hslu-ares/ares-parachute-pcb/ares-parachute-board.kicad_sch

## KiCad design ares-parachute-board.kicad_sch (2025-02-18)

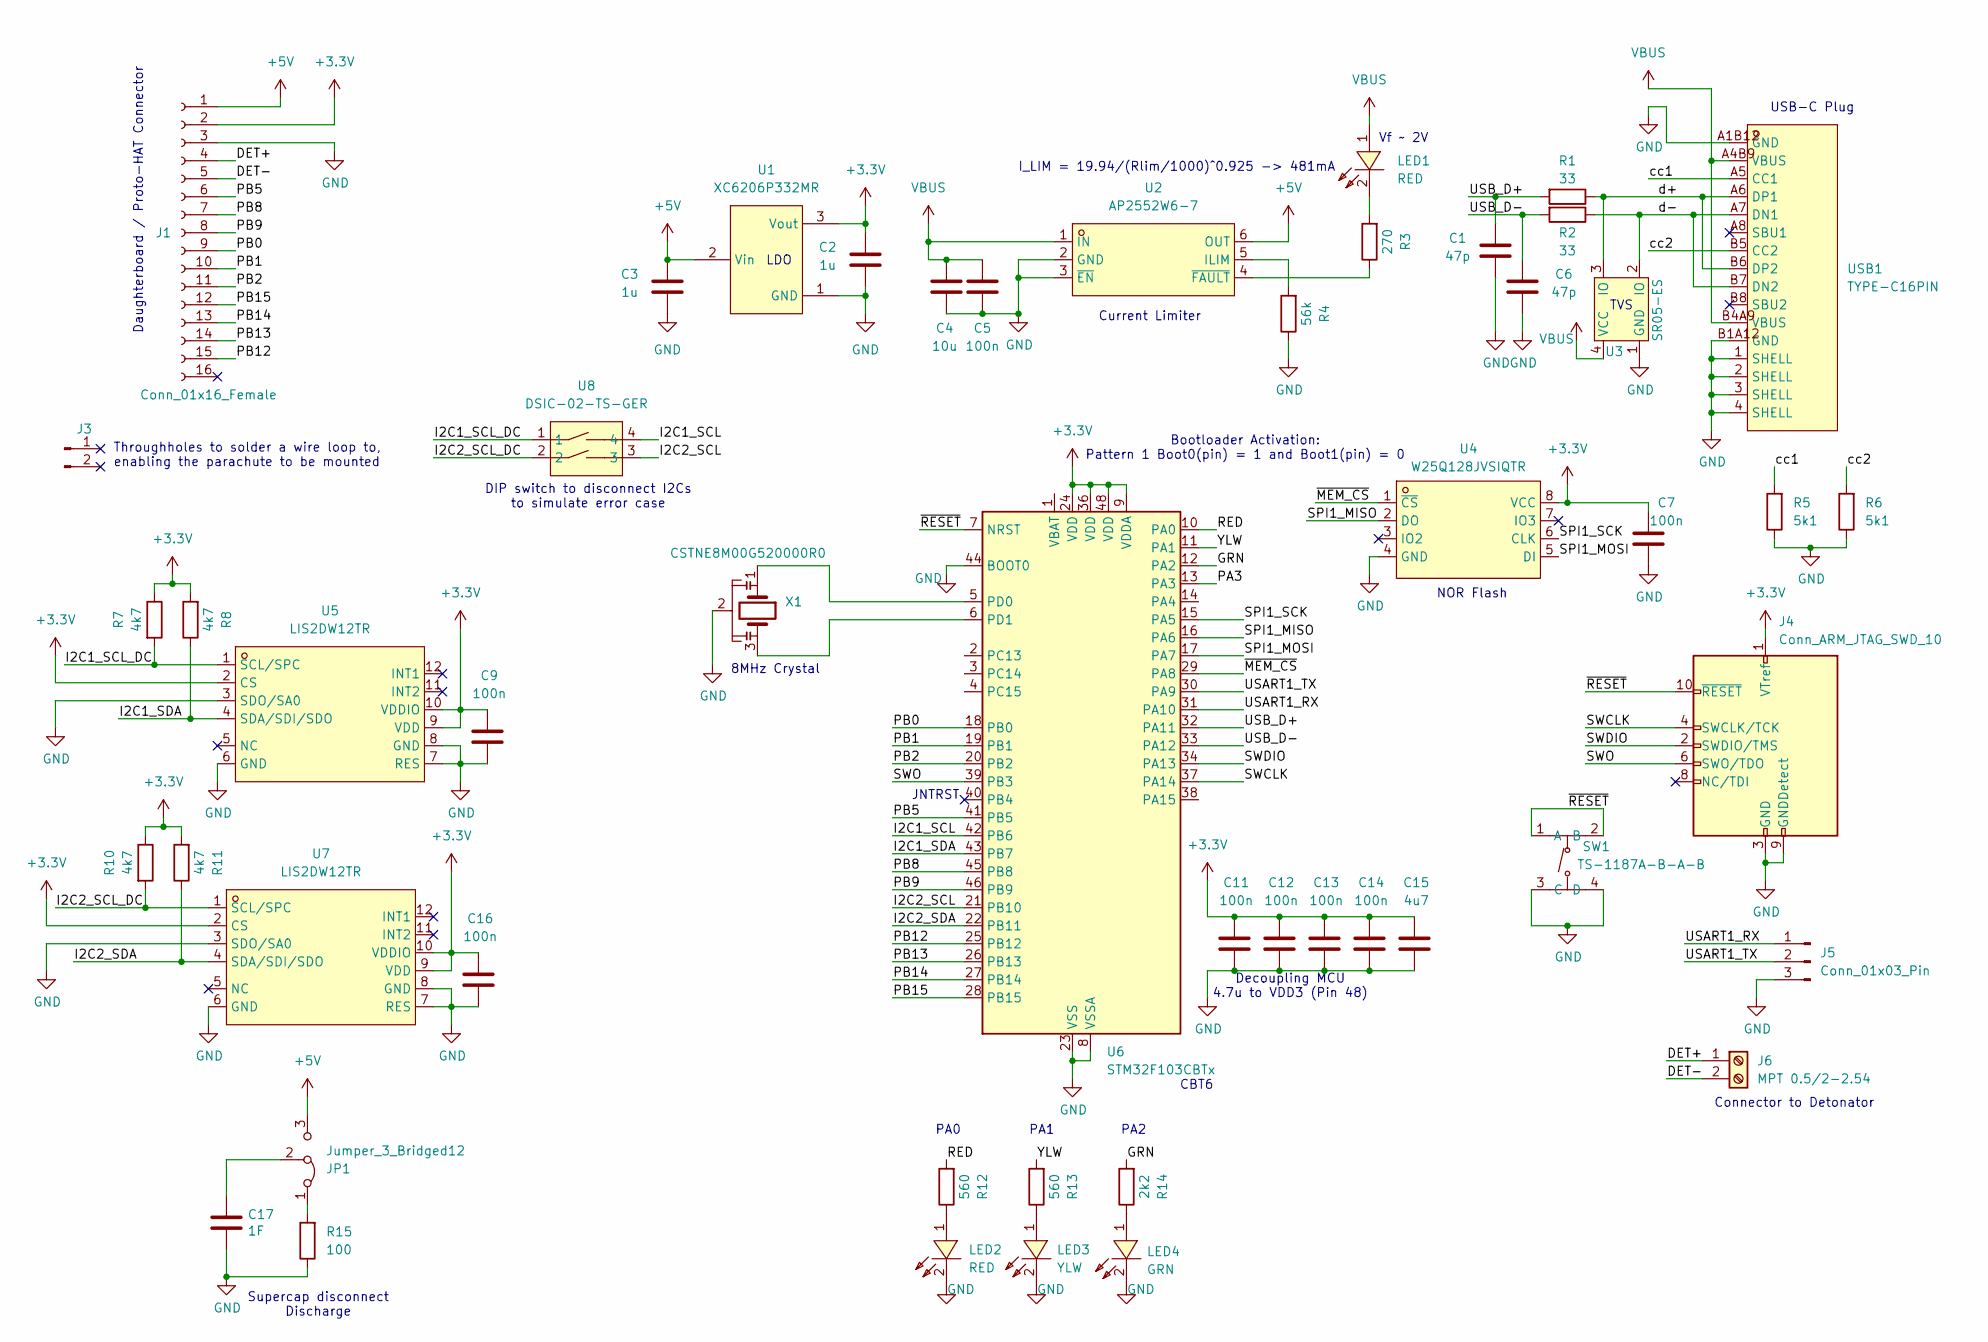
[picture p1: schematic ares-parachute-board.kicad_sch]

Parts:
C1, C6: 47p; C_0603_1608Metric; LCSC Part C1648
C2, C3: 1u; C_0603_1608Metric; LCSC Part C1648
C4: 10u; C_0603_1608Metric; LCSC Part C1648
C5, C7, C9, C11, C12, C13, C14, C16: 100n; C_0603_1608Metric; LCSC Part C1648
C15: 4u7; C_0603_1608Metric; LCSC Part C1648
C17: 1F; SCMR18C105MRBA0; Mouser 581-SCMR18C105MRBA0
J1: Conn_01x16_Female; PinHeader_1x16_P2.54mm_Vertical
J3: Conn_01x02_Male; PinHeader_1x02_P2.54mm_Vertical
J4: Conn_ARM_JTAG_SWD_10; PinHeader_2x05_P1.27mm_Vertical; LCSC Part C7501289
J5: Conn_01x03_Pin; PinHeader_1x03_P2.54mm_Horizontal
J6: MPT 0.5/2-2.54; TerminalBlock_Phoenix_MPT-0,5-2-2.54_1x02_P2.54mm_Horizontal
JP1: Jumper_3_Bridged12; PinHeader_1x03_P2.54mm_Horizontal
LED1, LED2: RED; LED0805-R-RD; LCSC Part C84256
LED3: YLW; LED0805-R-RD; LCSC Part C2296
LED4: GRN; LED0805-R-RD; LCSC Part C2297
R1, R2: 33; R_0603_1608Metric; LCSC C23140
R3: 270; R_0603_1608Metric; LCSC C22966
R4: 56k; R_0603_1608Metric; LCSC C23206
R5, R6: 5k1; R_0603_1608Metric; LCSC C23186
R7, R8, R10, R11: 4k7; R_0603_1608Metric; LCSC C23162
R12, R13: 560; R_0603_1608Metric; LCSC C23204
R14: 2k2; R_0603_1608Metric; LCSC C4190
R15: 100; R_0603_1608Metric; LCSC C22775
SW1: TS-1187A-B-A-B; SW-SMD_4P-L5.1-W5.1-P3.70-LS6.5-TL_H1.5; LCSC Part C318884
U1: XC6206P332MR; SOT-23-3_L2.9-W1.6-P1.90-LS2.8-BR; LCSC Part C5446
U2: AP2552W6-7; SOT-26_L3.0-W1.6-P0.95-LS2.8-BL; LCSC Part C441824
U3: SR05-ES; SOT-143; LCSC Part C5180250
U4: W25Q128JVSIQTR; SOIC-8_L5.3-W5.3-P1.27-LS8.0-BL; LCSC Part C97521
U5, U7: LIS2DW12TR; LGA-12_L2.0-W2.0-P0.50-BL; LCSC Part C189624
U6: STM32F103CBTx; LQFP-48_7x7mm_P0.5mm; LCSC C8304
U8: DSIC-02-TS-GER; SW-SMD_DSIC-02-TS-GER; LCSC Part C7471373
USB1: TYPE-C16PIN; USB-C-SMD_TYPE-C16PIN; LCSC Part C393939
X1: CSTNE8M00G520000R0; OSC-SMD_3P-L3.2-W1.3-P1.20; LCSC Part C907975

Connections:
+3.3V: C2.1, C7.1, C9.1, C11.1, C12.1, C13.1, C14.1, C15.1, C16.1, J1.2, J4.1 (VTref), R7.1, R8.2, R10.1, R11.2, U1.3 (Vout), U4.8 (VCC), U5.2 (CS), U5.9 (VDD), U5.10 (VDDIO), U6.9 (VDDA), U6.24 (VDD), U6.36 (VDD), U6.48 (VDD), U7.2 (CS), U7.9 (VDD), U7.10 (VDDIO)
+5V: C3.1, J1.1, JP1.3 (B), U1.2 (Vin), U2.6 (OUT)
DET+: J1.4, J6.1
DET-: J1.5, J6.2
GND: C1.2, C2.2, C3.2, C4.2, C5.2, C6.2, C7.2, C9.2, C11.2, C12.2, C13.2, C14.2, C15.2, C16.2, C17.2, J1.3, J4.3 (GND), J4.5 (GND), J4.9 (GNDDetect), J5.3, LED2.2, LED3.2, LED4.2, R4.1, R5.1, R6.1, R15.1, SW1.3 (C), SW1.4 (D), U1.1 (GND), U2.2 (GND), U2.3 (~EN), U3.1 (GND), U4.4 (GND), U5.3 (SDO/SA0), U5.6 (GND), U5.7 (RES), U5.8 (GND), U6.8 (VSSA), U6.23 (VSS), U6.35 (VSS), U6.44 (BOOT0), U6.47 (VSS), U7.3 (SDO/SA0), U7.6 (GND), U7.7 (RES), U7.8 (GND), USB1.1 (SHELL), USB1.2 (SHELL), USB1.3 (SHELL), USB1.4 (SHELL), USB1.A1B12 (GND), USB1.B1A12 (GND), X1.2
GRN: R14.2, U6.12 (PA2)
I2C1_SCL: U6.42 (PB6), U8.4
I2C1_SCL_DC: R7.2, U5.1 (SCL/SPC), U8.1
I2C1_SDA: R8.1, U5.4 (SDA/SDI/SDO), U6.43 (PB7)
I2C2_SCL: U6.21 (PB10), U8.3
I2C2_SCL_DC: R10.2, U7.1 (SCL/SPC), U8.2
I2C2_SDA: R11.1, U6.22 (PB11), U7.4 (SDA/SDI/SDO)
unnamed: C17.1, JP1.2 (C)
unnamed: JP1.1 (A), R15.2
unnamed: LED1.2, R3.2
unnamed: LED2.1, R12.1
unnamed: LED3.1, R13.1
unnamed: LED4.1, R14.1
unnamed: R3.1, U2.4 (~FAULT)
unnamed: R4.2, U2.5 (ILIM)
unnamed: U6.5 (PD0), X1.1
unnamed: U6.6 (PD1), X1.3
PA3: U6.13 (PA3)
PB0: J1.9, U6.18 (PB0)
PB1: J1.10, U6.19 (PB1)
PB2: J1.11, U6.20 (PB2)
PB5: J1.6, U6.41 (PB5)
PB8: J1.7, U6.45 (PB8)
PB9: J1.8, U6.46 (PB9)
PB12: J1.15, U6.25 (PB12)
PB13: J1.14, U6.26 (PB13)
PB14: J1.13, U6.27 (PB14)
PB15: J1.12, U6.28 (PB15)
RED: R12.2, U6.10 (PA0)
SPI1_MISO: U4.2 (DO), U6.16 (PA6)
SPI1_MOSI: U4.5 (DI), U6.17 (PA7)
SPI1_SCK: U4.6 (CLK), U6.15 (PA5)
SWCLK: J4.4 (SWCLK/TCK), U6.37 (PA14)
SWDIO: J4.2 (SWDIO/TMS), U6.34 (PA13)
SWO: J4.6 (SWO/TDO), U6.39 (PB3)
USART1_RX: J5.1, U6.31 (PA10)
USART1_TX: J5.2, U6.30 (PA9)
USB_D+: C1.1, R1.2, U6.32 (PA11)
USB_D-: C6.1, R2.2, U6.33 (PA12)
VBUS: C4.1, C5.1, LED1.1, U2.1 (IN), U3.4 (VCC), USB1.A4B9 (VBUS), USB1.B4A9 (VBUS)
YLW: R13.2, U6.11 (PA1)
cc1: R5.2, USB1.A5 (CC1)
cc2: R6.2, USB1.B5 (CC2)
d+: R1.1, U3.3 (IO), USB1.A6 (DP1), USB1.B6 (DP2)
d-: R2.1, U3.2 (IO), USB1.A7 (DN1), USB1.B7 (DN2)
~MEM_CS: U4.1 (~CS), U6.29 (PA8)
~RESET: J4.10 (~RESET), SW1.1 (A), SW1.2 (B), U6.7 (NRST)

Notes on the sheet:
TVS
JNTRST
I_LIM = 19.94/(Rlim/1000)^0.925 -> 481mA
Throughholes to solder a wire loop to, enabling the parachute to be mounted
Bootloader Activation: Pattern 1 Boot0(pin) = 1 and Boot1(pin) = 0
Connector to Detonator
LDO
8MHz Crystal
PA2
DIP switch to disconnect I2Cs to simulate error case
NOR Flash
USB-C Plug
Vf ~ 2V
PA0
PA1
Current Limiter
CBT6
Decoupling MCU 4.7u to VDD3 (Pin 48)
Daughterboard / Proto-HAT Connector
Supercap disconnect Discharge
