hslu-ares/ares-parachute-pcb/asyd-parachute.kicad_sch

## KiCad design asyd-parachute.kicad_sch (2024-11-13)

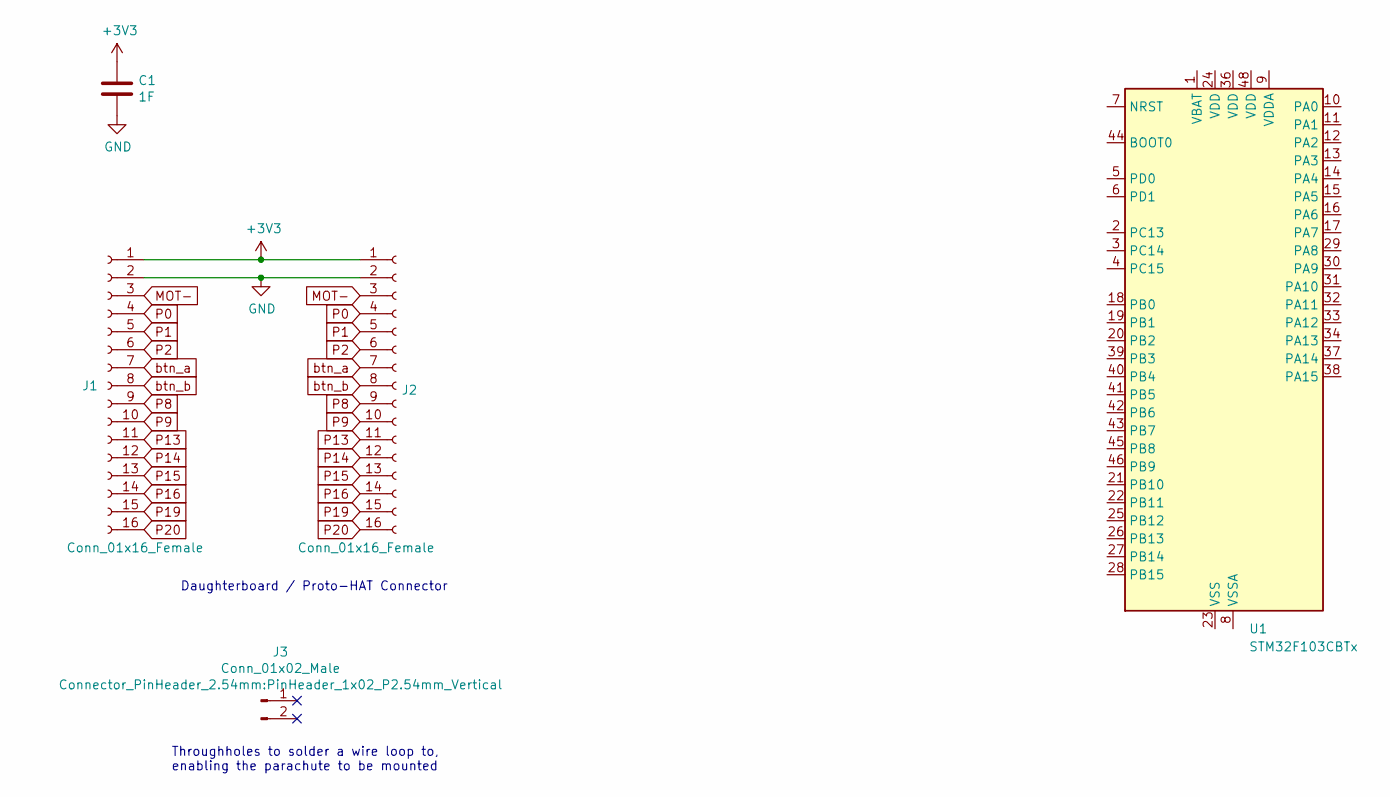
[picture p2: schematic asyd-parachute.kicad_sch]

Parts:
C1: 1F; SCMR18C105MRBA0; Mouser 581-SCMR18C105MRBA0
J1, J2: Conn_01x16_Female; PinHeader_1x16_P2.54mm_Vertical
J3: Conn_01x02_Male; PinHeader_1x02_P2.54mm_Vertical
U1: STM32F103CBTx; LQFP-48_7x7mm_P0.5mm

Connections:
+3V3: C1.1, J1.1, J2.1
GND: C1.2, J1.2, J2.2
MOT-: J1.3, J2.3
unnamed: U1.23 (VSS), U1.35 (VSS), U1.47 (VSS)
P0: J1.4, J2.4
P1: J1.5, J2.5
P2: J1.6, J2.6
P8: J1.9, J2.9
P9: J1.10, J2.10
P13: J1.11, J2.11
P14: J1.12, J2.12
P15: J1.13, J2.13
P16: J1.14, J2.14
P19: J1.15, J2.15
P20: J1.16, J2.16
btn_a: J1.7, J2.7
btn_b: J1.8, J2.8

Notes on the sheet:
Throughholes to solder a wire loop to, enabling the parachute to be mounted
Daughterboard / Proto-HAT Connector
