hslu-ares/ares-parachute-pcb/(commit log)

2024-11-13 rename project
    [ares-parachute-board.kicad_pcb, ares-parachute-board.kicad_sch]
2024-11-14 update, component selection almost done
    [ares-parachute-board.kicad_sch]
2024-11-14 updated schematic
    [ares-parachute-board.kicad_sch]
2024-11-15 updated schematic, moving on to routing
    [ares-parachute-board.kicad_sch]
2024-11-15 re-annotate, component placement complete
    [ares-parachute-board.kicad_pcb, ares-parachute-board.kicad_sch]
2024-11-15 about to try some stuff
    [ares-parachute-board.kicad_pcb, ares-parachute-board.kicad_sch]
2024-11-15 layout done
    [ares-parachute-board.kicad_pcb, ares-parachute-board.kicad_sch]
2024-11-15 added testpoints, not on board yet
    [ares-parachute-board.kicad_pcb, ares-parachute-board.kicad_sch]
2024-11-15 added testpoints
    [ares-parachute-board.kicad_pcb]
2025-01-21 add dip switch to errata/to add
2025-01-21 update board for prototype 2
    [ares-parachute-board.kicad_pcb, ares-parachute-board.kicad_sch]
2025-02-14 ordered version 1.0
    [ares-parachute-board-CuBottom.gbr, ares-parachute-board-CuTop.gbr, ares-parachute-board-EdgeCuts.gbr, ares-parachute-board-MaskBottom.gbr, ares-parachute-board-MaskTop.gbr, ares-parachute-board-NPTH.drl, ares-parachute-board-PTH.drl, ares-parachute-board-PasteBottom.gbr]
2025-02-18 fix error in reset button placement for future revision
    [ares-parachute-board.kicad_pcb, ares-parachute-board.kicad_sch]
