hslu-ares/ares-parachute-pcb/(notices)

Notices in the files:
asyd-parachute.kicad_pcb:
(c) 2023 Hochschule Luzern, Technik & Architektur
